DraganMicic/laser-communication/README.md

# laser-communication

Sending text messages between 2 computers using lasers and photosensors controlled by ATMEGA3285 microcontroller. Graduation thesis. (2022)
