DraganMicic/laser-communication/LaserskaKomunikacija_DMicic_PREZENTACIJA.pdf

Diplomski rad

# Laserska komunikacija

## Računarski fakultet Beograd

Kandidat
Dragan Mićić

Mentor
prof. Dr Đorđe Babić

# Inspiracija i ideja

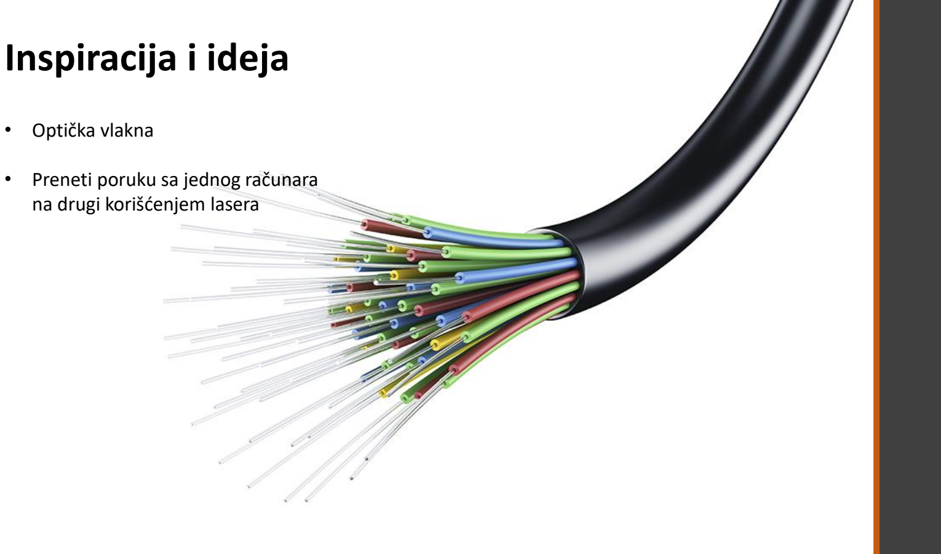
[picture p21: page 2]

- Optička vlakna
- Preneti poruku sa jednog računara na drugi korišćenjem lasera

# Opis sistema

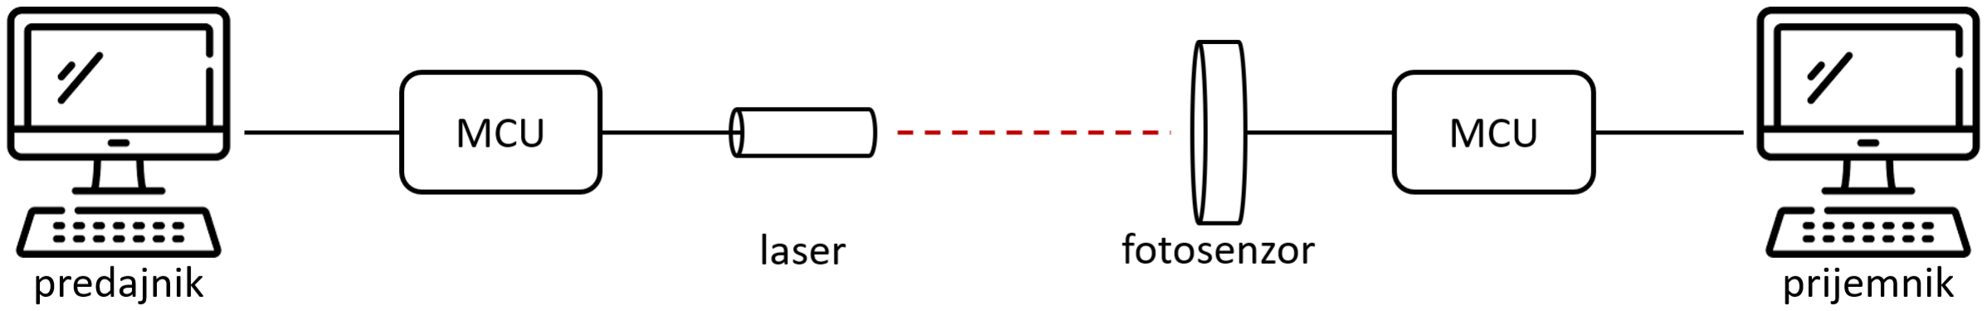
[picture p22: figure]

# Mikrokontroleri

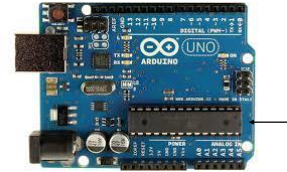
[picture p23: figure]

MCU | MCU
- Atmega238p
- Arduino razvojno okruženje

# UART protokol

- Universal asynchronous receiver – transmitter
- Jedan kanal po smeru
- Full duplex
- Frekvencija odabiranja (baud rate)

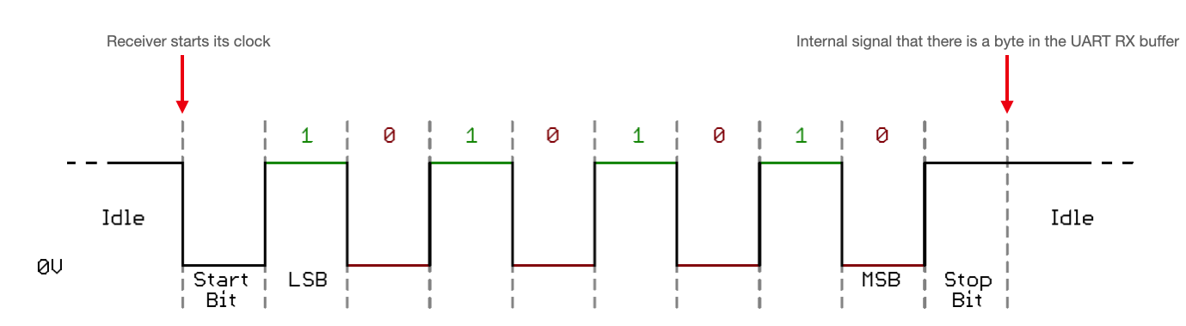
[picture p24: figure]

MCU | MCU

# Laser

- Light Amplification by Stimulated Emission of Radiation
- Poluprovodnički crveni laser (640nm)

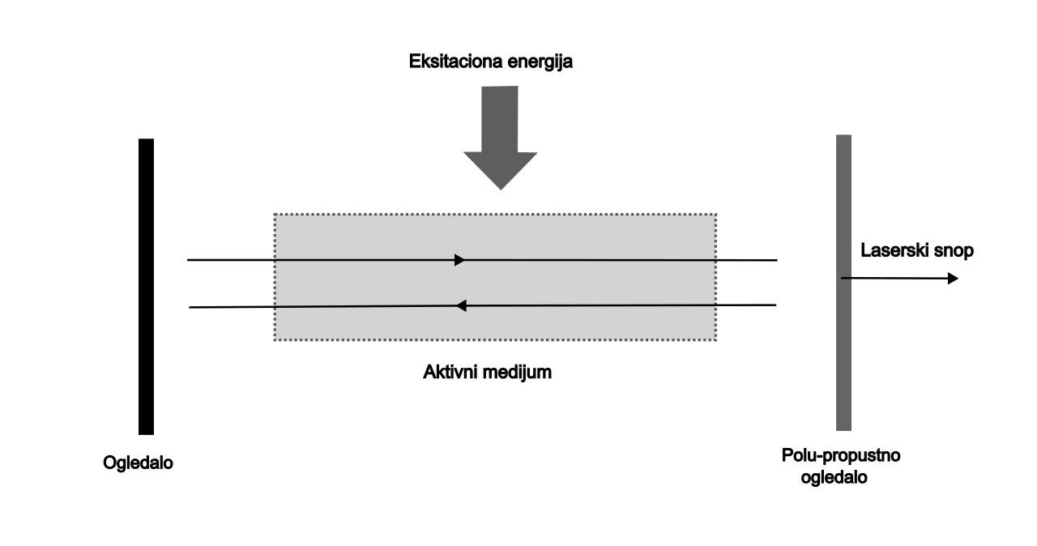
[picture p25: figure]
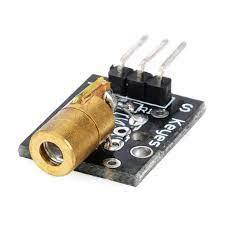
[picture p26: figure]

MCU | MCU

# Fotosenzori

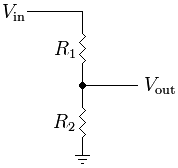
[picture p27: figure]

- Fotootpornik
- Fotodioda
- Naponski razdelnik

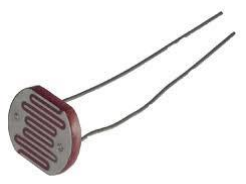
[picture p28: figure]
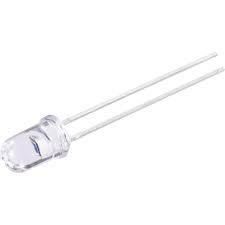
[picture p29: figure]

MCU | MCU

# Predajnik

- ASCI binarni kod
- Modulacije:
- Vremenska
- Direktna
MCU | MCU

# Vremenska modulacija

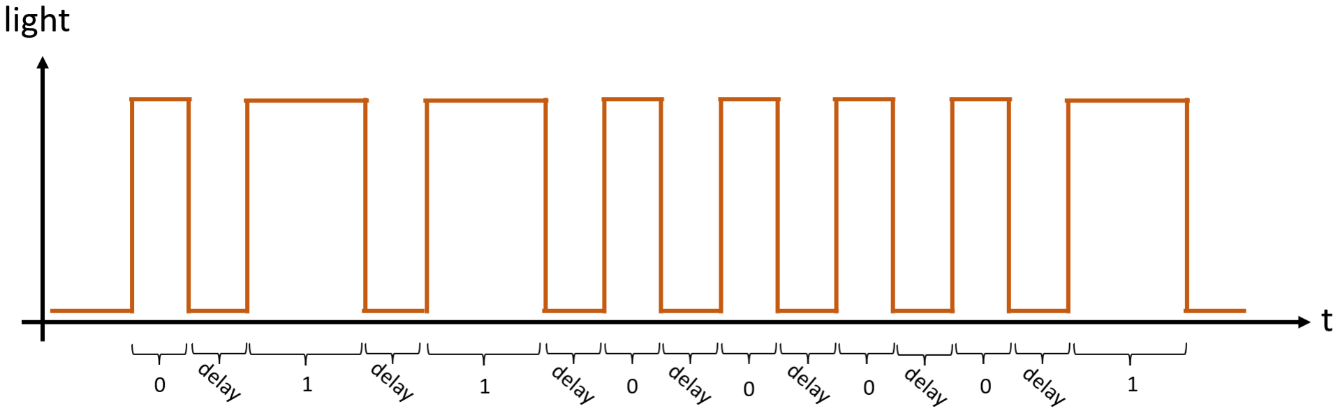
[picture p30: figure]

MCU | MCU

# Direktna modulacija

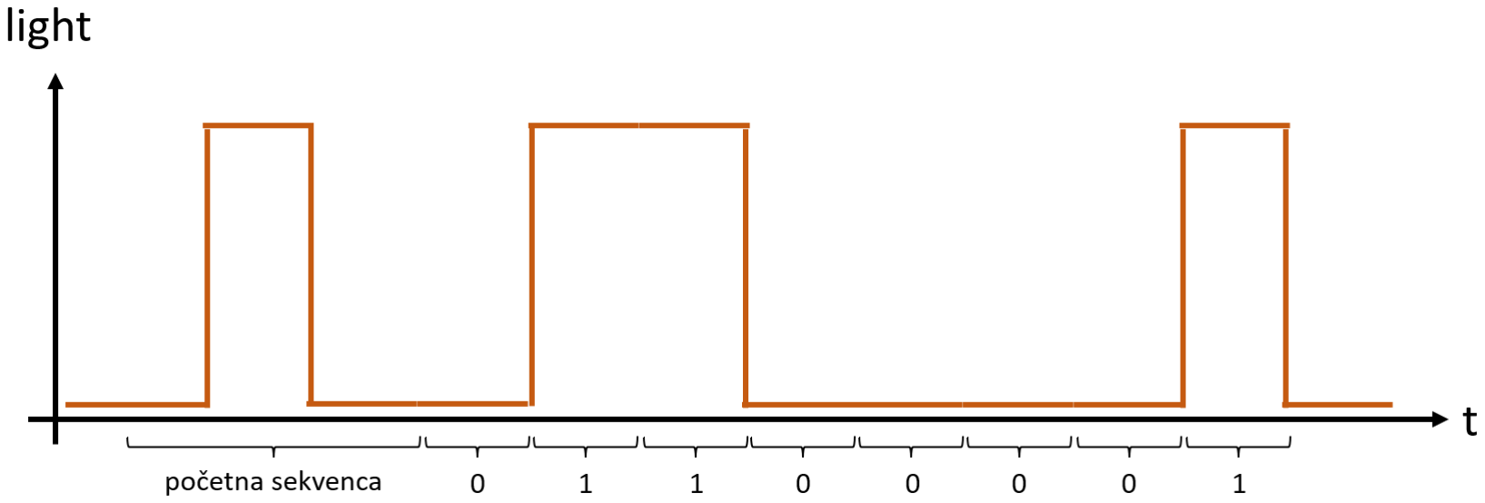
[picture p31: figure]

MCU | MCU

# Prijemnik

MCU | MCU
- ADC
- Binarizacija
- Ograničenje odziva fotosenzora

# Karakteristike fotosenzora

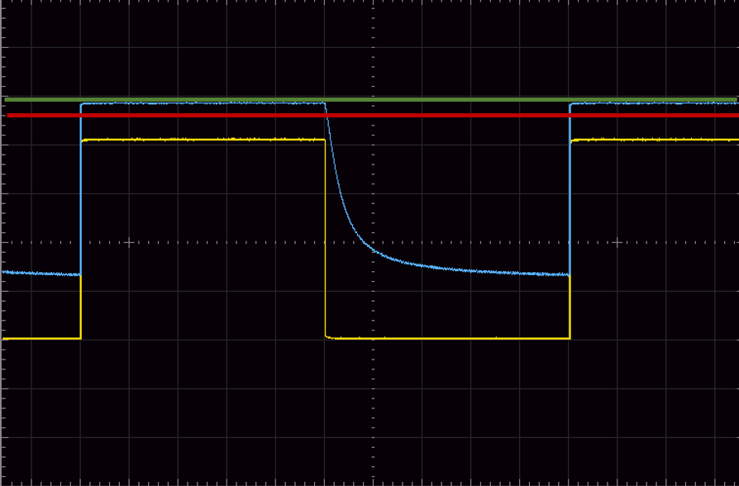
[picture p32: figure]
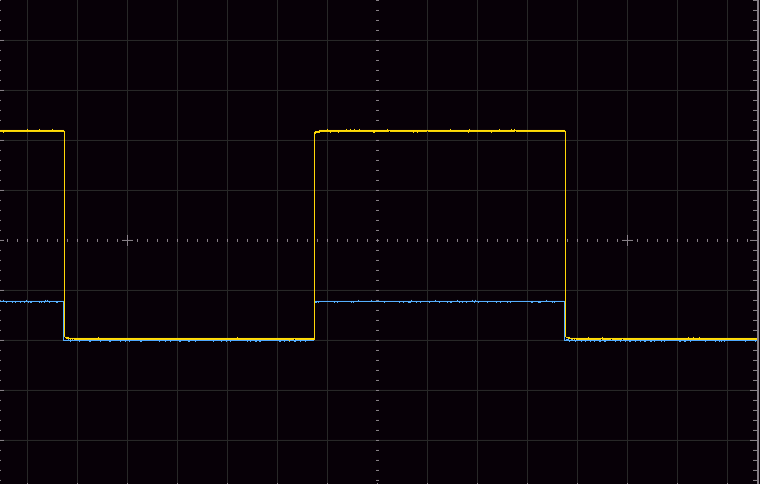
[picture p33: figure]

MCU | MCU
fotootpornik | fotodioda

# Rezultati

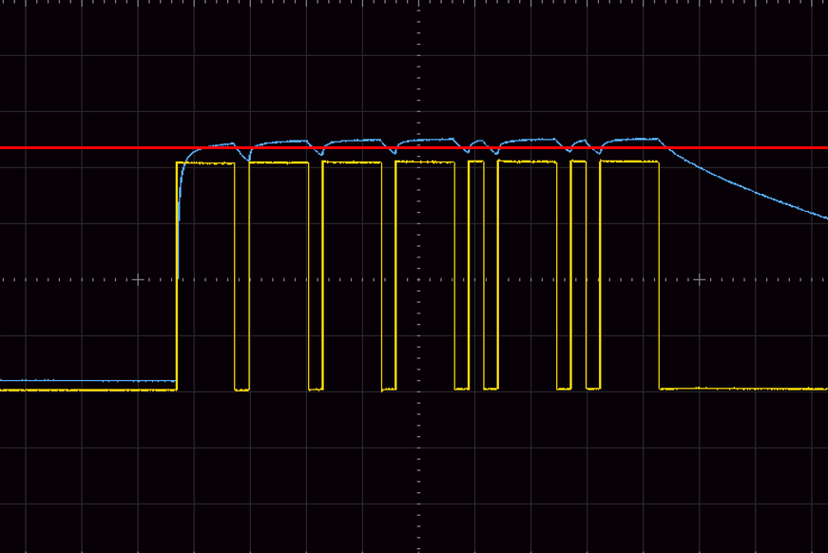
[picture p34: figure]
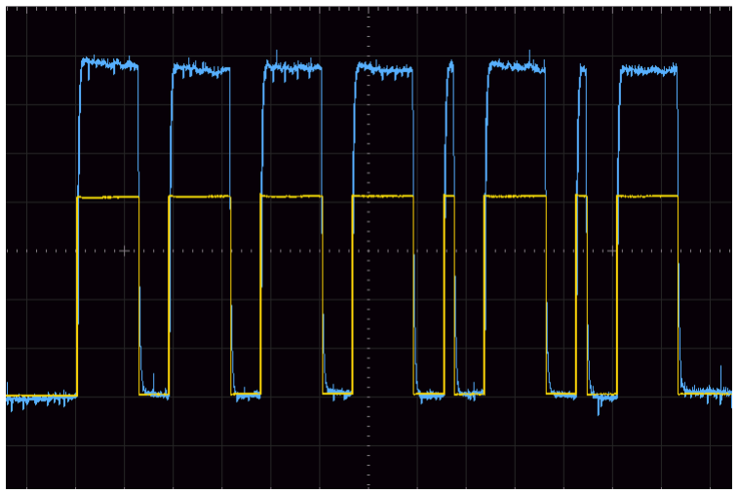
[picture p35: figure]

fotootpornik | fotodioda
- Vremenska modulacija

# Rezultati

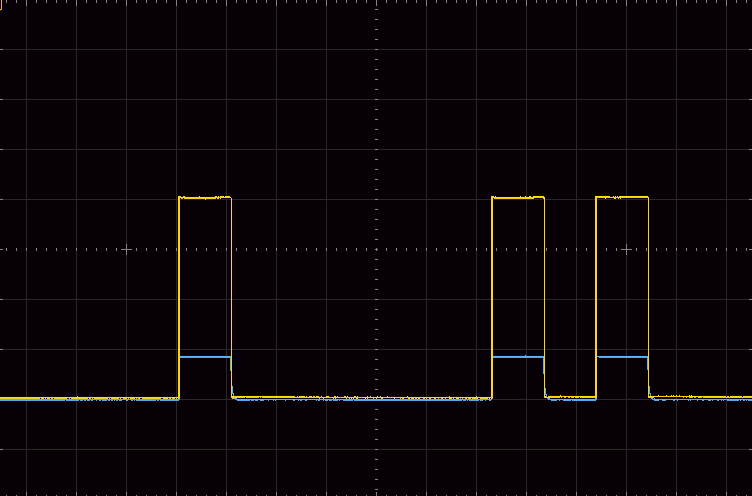
[picture p36: figure]
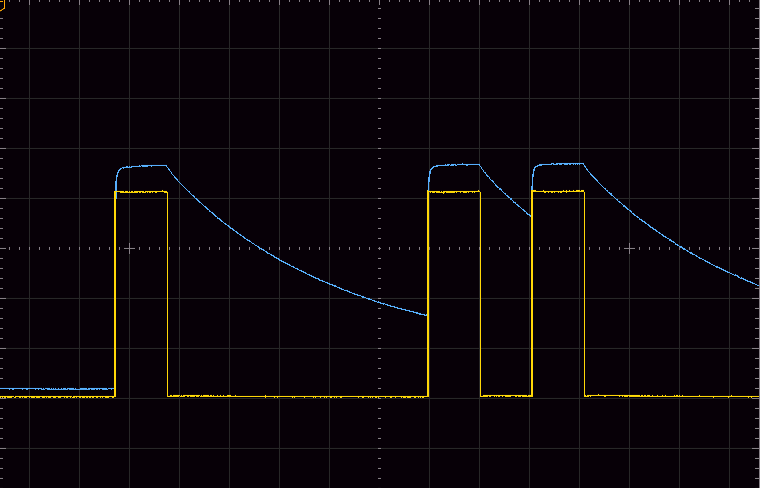
[picture p37: figure]

fotootpornik | fotodioda
- Direktnaa modulacija

# Rezultati

Vremenska modulacija

- Maksimalna brzina protoka

Direktna modulacija

# Rezultati Diskusija

- Maksimalna postignute brzina protoka
maksimalne postignute brzine protoka | fotootpornik kao prijemnik | fotodioda kao prijemnik
vremenska modulacija | 570bit/s | 1528bit/s
direktna modulacija | 73bit/s | 91bit/s

# Moguća unapređenja

- Korišćenje dodatnih linija za sinhronizaciju
- Korišćenje bržih mikrokontrolera
- Korišćenje algoritama za kompresiju podataka
- Korišćenje algoritama za detekciju i ispravljanje greške

# Demonstracija

video

# Hvala na pažnji!

# Pitanja?
