DraganMicic/laser-communication/Arduino and breadboard holder.stl

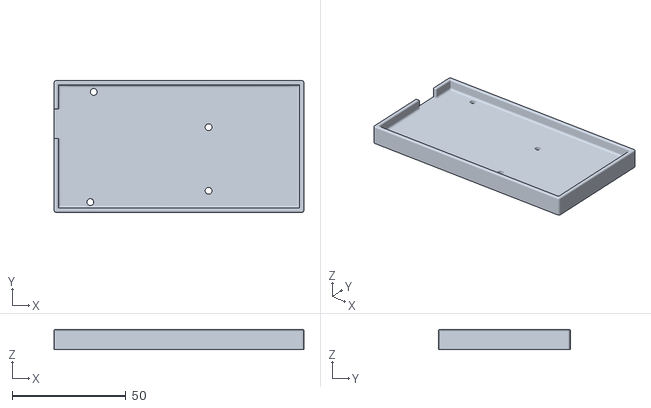
[picture p38: CAD file, 2023-02-03]
Arduino and breadboard holder.stl
110.0 x 58.0 x 9.00
